rasteri/dISAppointment/README.md

# dISAppointment
Adding ISA slots to modern motherboards
