rasteri/dISAppointment/hardware/disappointment v1.stl

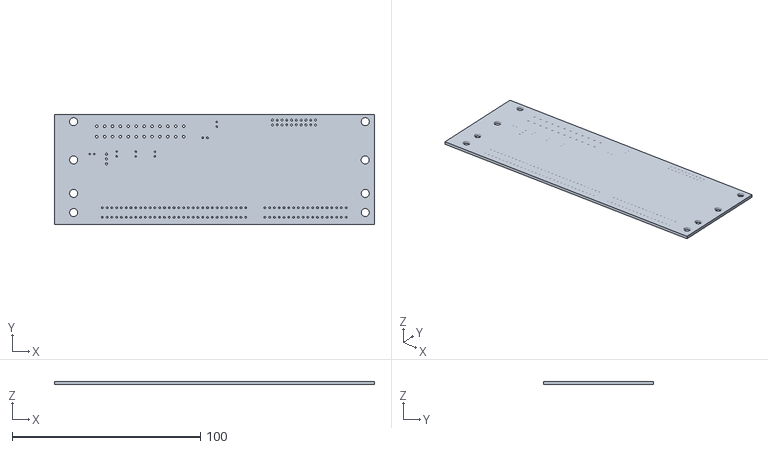
[picture p1: CAD file, 2023-08-16]
hardware/disappointment v1.stl
170.0 x 58.4 x 1.58
