rasteri/dISAppointment/hardware/NEW.pdf

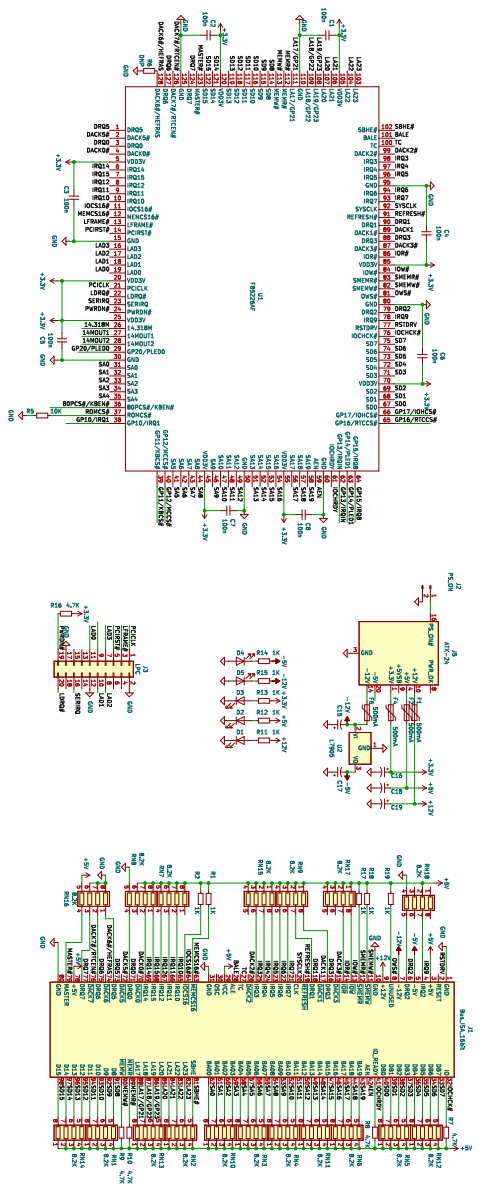
[picture p2: page 1]
