rasteri/dISAppointment/hardware/disappointment.kicad_pcb

## KiCad design hardware/disappointment.kicad_pcb (2025-01-30)

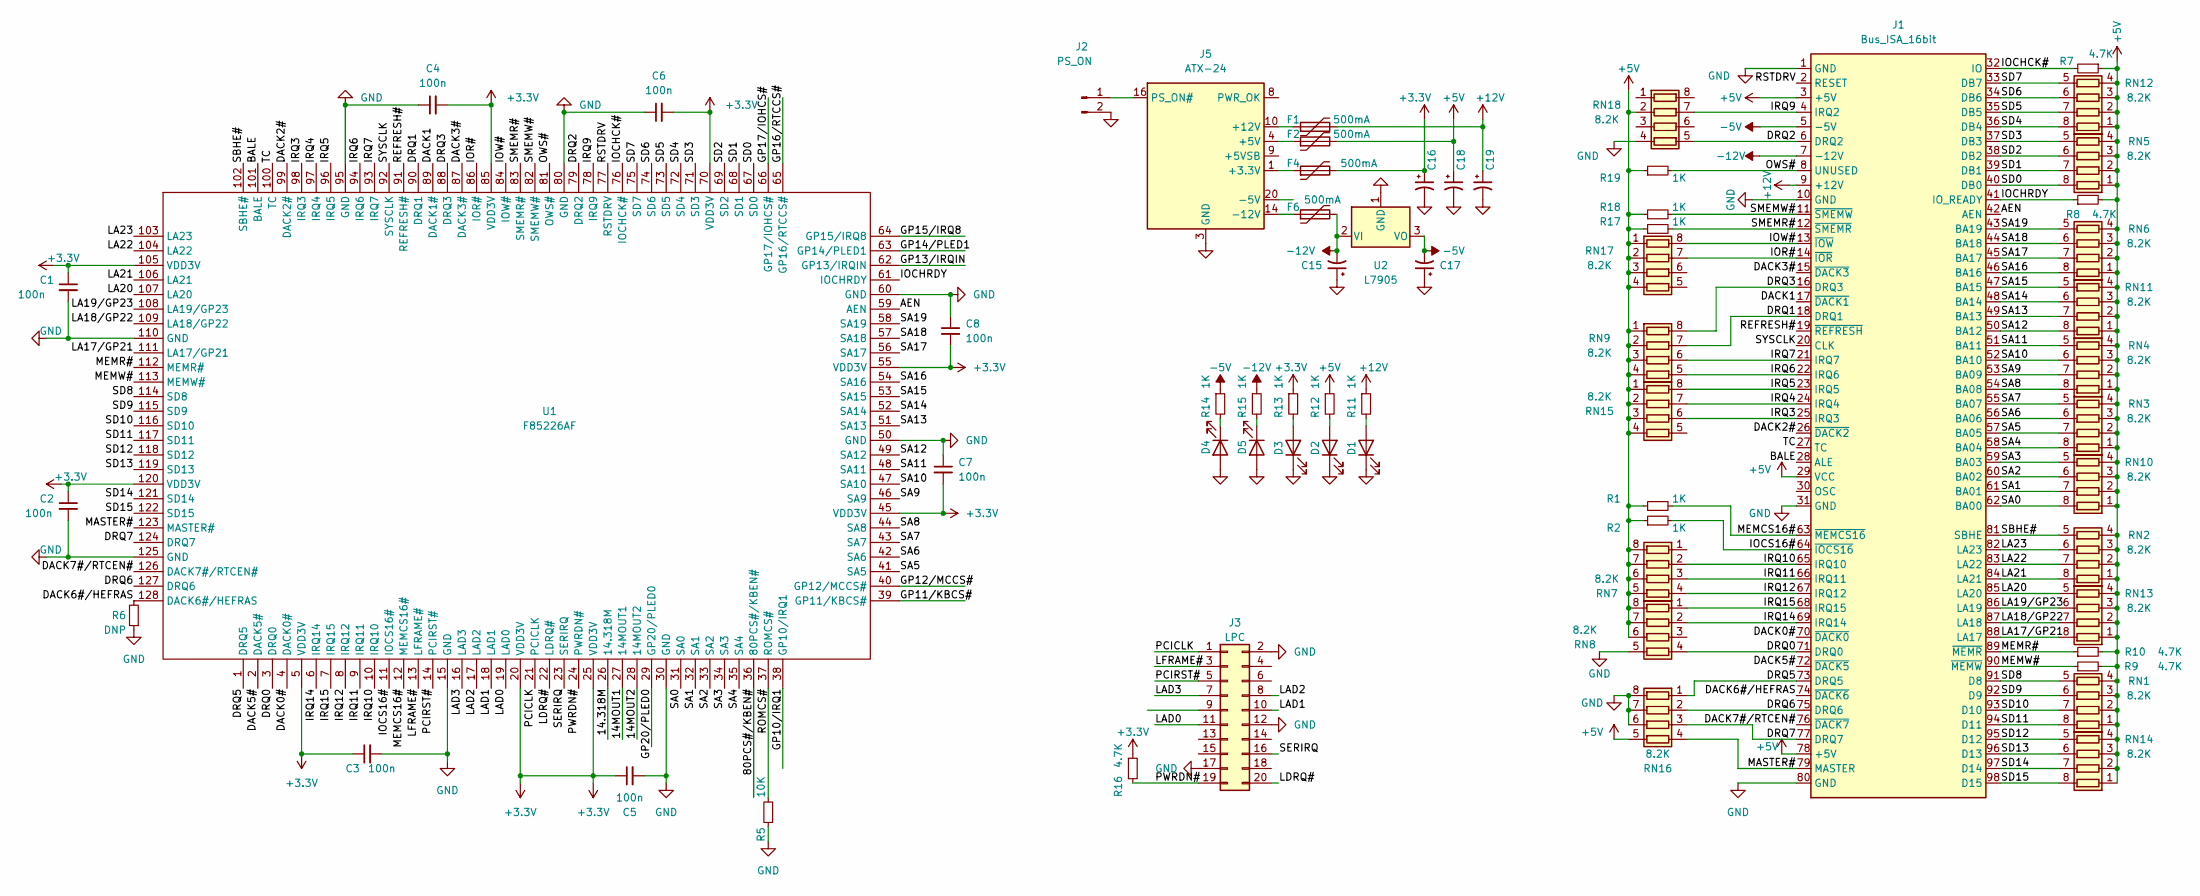
[picture p3: schematic disappointment.kicad_sch]

Parts:
C1, C2, C3, C4, C5, C6, C7, C8: 100n; C_1206_3216Metric
C15, C16, C17, C18, C19: 10uF; CP_Radial_D5.0mm_P2.50mm
D1, D2, D3, D4, D5: LED; LED_1206_3216Metric
F1, F2, F4, F6: 500mA; Fuse_1206_3216Metric
J1: Bus_ISA_16bit; ISA
J2: PS_ON; PinHeader_1x02_P2.54mm_Vertical
J3: LPC; PinHeader_2x10_P2.54mm_Vertical
J5: ATX-24; Molex_Mini-Fit_Jr_5566-24A_2x12_P4.20mm_Vertical
R1, R2, R11, R12, R13, R14, R15, R17, R18, R19: 1K; R_1206_3216Metric_Pad1.30x1.75mm_HandSolder
R5: 10K; R_1206_3216Metric_Pad1.30x1.75mm_HandSolder
R6: DNP; R_1206_3216Metric_Pad1.30x1.75mm_HandSolder
R7, R8, R9, R10, R16: 4.7K; R_1206_3216Metric_Pad1.30x1.75mm_HandSolder
RN1, RN2, RN3, RN4, RN5, RN6, RN7, RN8, RN9, RN10, RN11, RN12, RN13, RN14, RN15, RN16, RN17, RN18: 8.2K; R_Array_Concave_4x0603
U1: F85226AF; QFP-26x38_14x20_Pitch0.5mm
U2: L7905; TO-220-3_Vertical

Connections:
+3.3V: C1.1, C2.1, C3.1, C4.2, C5.1, C6.2, C7.2, C8.2, C16.1, F4.2, R13.1, R16.1, U1.5 (VDD3V), U1.20 (VDD3V), U1.25 (VDD3V), U1.45 (VDD3V), U1.55 (VDD3V), U1.70 (VDD3V), U1.85 (VDD3V), U1.105 (VDD3V), U1.120 (VDD3V)
+5V: C18.1, F2.2, J1.3 (+5V), J1.29 (VCC), J1.78 (+5V), R1.1, R2.1, R7.1, R8.2, R9.2, R10.2, R12.1, R17.1, R18.1, R19.1, RN1.1 (R1.1), RN1.2 (R2.1), RN1.3 (R3.1), RN1.4 (R4.1), RN2.1 (R1.1), RN2.2 (R2.1), RN2.3 (R3.1), RN2.4 (R4.1), RN3.1 (R1.1), RN3.2 (R2.1), RN3.3 (R3.1), RN3.4 (R4.1), RN4.1 (R1.1), RN4.2 (R2.1), RN4.3 (R3.1), RN4.4 (R4.1), RN5.1 (R1.1), RN5.2 (R2.1), RN5.3 (R3.1), RN5.4 (R4.1), RN6.1 (R1.1), RN6.2 (R2.1), RN6.3 (R3.1), RN6.4 (R4.1), RN7.5 (R4.2), RN7.6 (R3.2), RN7.7 (R2.2), RN7.8 (R1.2), RN8.6 (R3.2), RN8.7 (R2.2), RN8.8 (R1.2), RN9.1 (R1.1), RN9.2 (R2.1), RN9.3 (R3.1), RN9.4 (R4.1), RN10.1 (R1.1), RN10.2 (R2.1), RN10.3 (R3.1), RN10.4 (R4.1), RN11.1 (R1.1), RN11.2 (R2.1), RN11.3 (R3.1), RN11.4 (R4.1), RN12.1 (R1.1), RN12.2 (R2.1), RN12.3 (R3.1), RN12.4 (R4.1), RN13.1 (R1.1), RN13.2 (R2.1), RN13.3 (R3.1), RN13.4 (R4.1), RN14.1 (R1.1), RN14.2 (R2.1), RN14.3 (R3.1), RN14.4 (R4.1), RN15.1 (R1.1), RN15.2 (R2.1), RN15.3 (R3.1), RN15.4 (R4.1), RN16.5 (R4.2), RN17.1 (R1.1), RN17.2 (R2.1), RN17.3 (R3.1), RN17.4 (R4.1), RN18.2 (R2.1)
+12V: C19.1, F1.2, J1.9 (+12V), R11.1
-5V: C17.2, J1.5 (-5V), R14.1, U2.3 (VO)
-12V: C15.2, F6.2, J1.7 (-12V), R15.1, U2.2 (VI)
/14.318M: U1.26 (14.318M)
/14MOUT1: U1.27 (14MOUT1)
/14MOUT2: U1.28 (14MOUT2)
/80PCS#/KBEN#: U1.36 (80PCS#/KBEN#)
/AEN: J1.42 (AEN), U1.59 (AEN)
/BALE: J1.28 (ALE), U1.101 (BALE)
/DACK0#: J1.70 (~DACK0), U1.4 (DACK0#)
/DACK1: J1.17 (~DACK1), U1.89 (DACK1#)
/DACK2#: J1.26 (~DACK2), U1.99 (DACK2#)
/DACK3#: J1.15 (~DACK3), U1.87 (DACK3#)
/DACK5#: J1.72 (~DACK5), U1.2 (DACK5#)
/DACK6#/HEFRAS: J1.74 (~DACK6), R6.2, U1.128 (DACK6#/HEFRAS)
/DACK7#/RTCEN#: J1.76 (~DACK7), U1.126 (DACK7#/RTCEN#)
/DRQ0: J1.71 (DRQ0), RN8.4 (R4.1), U1.3 (DRQ0)
/DRQ1: J1.18 (DRQ1), RN9.7 (R2.2), U1.90 (DRQ1)
/DRQ2: J1.6 (DRQ2), RN18.5 (R4.2), U1.79 (DRQ2)
/DRQ3: J1.16 (DRQ3), RN9.8 (R1.2), U1.88 (DRQ3)
/DRQ5: J1.73 (DRQ5), RN16.1 (R1.1), U1.1 (DRQ5)
/DRQ6: J1.75 (DRQ6), RN16.2 (R2.1), U1.127 (DRQ6)
/DRQ7: J1.77 (DRQ7), RN16.3 (R3.1), U1.124 (DRQ7)
/GP10/IRQ1: U1.38 (GP10/IRQ1)
/GP11/KBCS#: U1.39 (GP11/KBCS#)
/GP12/MCCS#: U1.40 (GP12/MCCS#)
/GP13/IRQIN: U1.62 (GP13/IRQIN)
/GP14/PLED1: U1.63 (GP14/PLED1)
/GP15/IRQ8: U1.64 (GP15/IRQ8)
/GP16/RTCCS#: U1.65 (GP16/RTCCS#)
/GP17/IOHCS#: U1.66 (GP17/IOHCS#)
/GP20/PLED0: U1.29 (GP20/PLED0)
/IOCHCK#: J1.32 (IO), R7.2, U1.76 (IOCHCK#)
/IOCHRDY: J1.41 (IO_READY), R8.1, U1.61 (IOCHRDY)
/IOCS16#: J1.64 (~IOCS16), R2.2, U1.11 (IOCS16#)
/IOR#: J1.14 (~IOR), RN17.7 (R2.2), U1.86 (IOR#)
/IOW#: J1.13 (~IOW), RN17.8 (R1.2), U1.84 (IOW#)
/IRQ3: J1.25 (IRQ3), RN15.6 (R3.2), U1.98 (IRQ3)
/IRQ4: J1.24 (IRQ4), RN15.7 (R2.2), U1.97 (IRQ4)
/IRQ5: J1.23 (IRQ5), RN15.8 (R1.2), U1.96 (IRQ5)
/IRQ6: J1.22 (IRQ6), RN9.5 (R4.2), U1.94 (IRQ6)
/IRQ7: J1.21 (IRQ7), RN9.6 (R3.2), U1.93 (IRQ7)
/IRQ9: J1.4 (IRQ2), RN18.7 (R2.2), U1.78 (IRQ9)
/IRQ10: J1.65 (IRQ10), RN7.2 (R2.1), U1.10 (IRQ10)
/IRQ11: J1.66 (IRQ11), RN7.3 (R3.1), U1.9 (IRQ11)
/IRQ12: J1.67 (IRQ12), RN7.4 (R4.1), U1.8 (IRQ12)
/IRQ14: J1.69 (IRQ14), RN8.2 (R2.1), U1.6 (IRQ14)
/IRQ15: J1.68 (IRQ15), RN8.1 (R1.1), U1.7 (IRQ15)
/LA17/GP21: J1.88 (LA17), RN13.8 (R1.2), U1.111 (LA17/GP21)
/LA18/GP22: J1.87 (LA18), RN13.7 (R2.2), U1.109 (LA18/GP22)
/LA19/GP23: J1.86 (LA19), RN13.6 (R3.2), U1.108 (LA19/GP23)
/LA20: J1.85 (LA20), RN13.5 (R4.2), U1.107 (LA20)
/LA21: J1.84 (LA21), RN2.8 (R1.2), U1.106 (LA21)
/LA22: J1.83 (LA22), RN2.7 (R2.2), U1.104 (LA22)
/LA23: J1.82 (LA23), RN2.6 (R3.2), U1.103 (LA23)
/LAD0: J3.11, U1.19 (LAD0)
/LAD1: J3.10, U1.18 (LAD1)
/LAD2: J3.8, U1.17 (LAD2)
/LAD3: J3.7, U1.16 (LAD3)
/LDRQ#: J3.20, U1.22 (LDRQ#)
/LFRAME#: J3.3, U1.13 (LFRAME#)
/MASTER#: J1.79 (MASTER), RN16.4 (R4.1), U1.123 (MASTER#)
/MEMCS16#: J1.63 (~MEMCS16), R1.2, U1.12 (MEMCS16#)
/MEMR#: J1.89 (~MEMR), R10.1, U1.112 (MEMR#)
/MEMW#: J1.90 (~MEMW), R9.1, U1.113 (MEMW#)
/OWS#: J1.8 (UNUSED), R19.2, U1.81 (OWS#)
/PCICLK: J3.1, U1.21 (PCICLK)
/PCIRST#: J3.5, U1.14 (PCIRST#)
/PWRDN#: J3.19, R16.2, U1.24 (PWRDN#)
/REFRESH#: J1.19 (~REFRESH), U1.91 (REFRESH#)
/ROMCS#: R5.2, U1.37 (ROMCS#)
/RSTDRV: J1.2 (RESET), U1.77 (RSTDRV)
/SA0: J1.62 (BA00), RN10.8 (R1.2), U1.31 (SA0)
/SA1: J1.61 (BA01), RN10.7 (R2.2), U1.32 (SA1)
/SA2: J1.60 (BA02), RN10.6 (R3.2), U1.33 (SA2)
/SA3: J1.59 (BA03), RN10.5 (R4.2), U1.34 (SA3)
/SA4: J1.58 (BA04), RN3.8 (R1.2), U1.35 (SA4)
/SA5: J1.57 (BA05), RN3.7 (R2.2), U1.41 (SA5)
/SA6: J1.56 (BA06), RN3.6 (R3.2), U1.42 (SA6)
/SA7: J1.55 (BA07), RN3.5 (R4.2), U1.43 (SA7)
/SA8: J1.54 (BA08), RN4.8 (R1.2), U1.44 (SA8)
/SA9: J1.53 (BA09), RN4.7 (R2.2), U1.46 (SA9)
/SA10: J1.52 (BA10), RN4.6 (R3.2), U1.47 (SA10)
/SA11: J1.51 (BA11), RN4.5 (R4.2), U1.48 (SA11)
/SA12: J1.50 (BA12), RN11.8 (R1.2), U1.49 (SA12)
/SA13: J1.49 (BA13), RN11.7 (R2.2), U1.51 (SA13)
/SA14: J1.48 (BA14), RN11.6 (R3.2), U1.52 (SA14)
/SA15: J1.47 (BA15), RN11.5 (R4.2), U1.53 (SA15)
/SA16: J1.46 (BA16), RN6.8 (R1.2), U1.54 (SA16)
/SA17: J1.45 (BA17), RN6.7 (R2.2), U1.56 (SA17)
/SA18: J1.44 (BA18), RN6.6 (R3.2), U1.57 (SA18)
/SA19: J1.43 (BA19), RN6.5 (R4.2), U1.58 (SA19)
/SBHE#: J1.81 (SBHE), RN2.5 (R4.2), U1.102 (SBHE#)
/SD0: J1.40 (DB0), RN5.8 (R1.2), U1.67 (SD0)
/SD1: J1.39 (DB1), RN5.7 (R2.2), U1.68 (SD1)
/SD2: J1.38 (DB2), RN5.6 (R3.2), U1.69 (SD2)
/SD3: J1.37 (DB3), RN5.5 (R4.2), U1.71 (SD3)
/SD4: J1.36 (DB4), RN12.8 (R1.2), U1.72 (SD4)
/SD5: J1.35 (DB5), RN12.7 (R2.2), U1.73 (SD5)
/SD6: J1.34 (DB6), RN12.6 (R3.2), U1.74 (SD6)
/SD7: J1.33 (DB7), RN12.5 (R4.2), U1.75 (SD7)
/SD8: J1.91 (D8), RN1.5 (R4.2), U1.114 (SD8)
/SD9: J1.92 (D9), RN1.6 (R3.2), U1.115 (SD9)
/SD10: J1.93 (D10), RN1.7 (R2.2), U1.116 (SD10)
/SD11: J1.94 (D11), RN1.8 (R1.2), U1.117 (SD11)
/SD12: J1.95 (D12), RN14.5 (R4.2), U1.118 (SD12)
/SD13: J1.96 (D13), RN14.6 (R3.2), U1.119 (SD13)
/SD14: J1.97 (D14), RN14.7 (R2.2), U1.121 (SD14)
/SD15: J1.98 (D15), RN14.8 (R1.2), U1.122 (SD15)
/SERIRQ: J3.16, U1.23 (SERIRQ)
/SMEMR#: J1.12 (~SMEMR), R17.2, U1.83 (SMEMR#)
/SMEMW#: J1.11 (~SMEMW), R18.2, U1.82 (SMEMW#)
/SYSCLK: J1.20 (CLK), U1.92 (SYSCLK)
/TC: J1.27 (TC), U1.100 (TC)
GND: C1.2, C2.2, C3.2, C4.1, C5.2, C6.1, C7.1, C8.1, C15.1, C16.2, C17.1, C18.2, C19.2, D1.1 (K), D2.1 (K), D3.1 (K), D4.2 (A), D5.2 (A), J1.1 (GND), J1.10 (GND), J1.31 (GND), J1.80 (GND), J2.2, J3.2, J3.12, J3.17, J5.3 (GND), J5.5 (GND), J5.7 (GND), J5.15 (GND), J5.17 (GND), J5.18 (GND), J5.19 (GND), J5.24 (GND), R5.1, R6.1, RN8.5 (R4.2), RN16.6 (R3.2), RN16.7 (R2.2), RN16.8 (R1.2), RN18.4 (R4.1), U1.15 (GND), U1.30 (GND), U1.50 (GND), U1.60 (GND), U1.80 (GND), U1.95 (GND), U1.110 (GND), U1.125 (GND), U2.1 (GND)
unnamed: D1.2 (A), R11.2
unnamed: D2.2 (A), R12.2
unnamed: D3.2 (A), R13.2
unnamed: D4.1 (K), R14.2
unnamed: D5.1 (K), R15.2
unnamed: F1.1, J5.10 (+12V), J5.11 (+12V)
unnamed: F2.1, J5.4 (+5V), J5.6 (+5V), J5.21 (+5V), J5.22 (+5V), J5.23 (+5V)
unnamed: F4.1, J5.1 (+3.3V), J5.2 (+3.3V), J5.12 (+3.3V), J5.13 (+3.3V)
unnamed: J2.1, J5.16 (PS_ON#)
unnamed: F6.1, J5.14 (-12V)

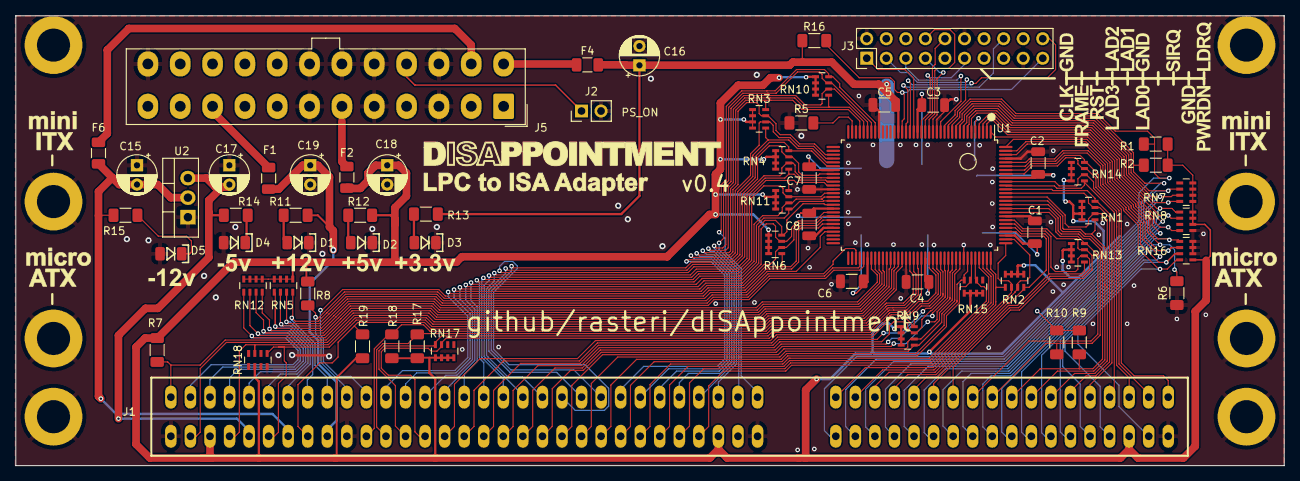
[picture p4: board disappointment.kicad_pcb from above]

Board: 2 copper layers, 164.7 x 58.4 mm, 63 parts (0 on the bottom side), 114 nets.
