rasteri/dISAppointment/(threads)

Thread 1 (2023-04-13):

Small bug in sapphisa.c

i440bx, 2023-04-13:
Hi,

in line 213 - 217 you disable the power management of the chip. But you send two times the same flags.
https://github.com/rasteri/dISAppointment/blob/5d25a476c166709765c10503f642b00895f9b2d3/software/sapphisa.c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

I think in 216 you want to send 0x52 ?

Thanks,
Robert

Thread 2 (2023-04-16):

Value of the resistor networks?

sycophantic, 2023-04-16:
The schematic shows the value of the resistor networks as "R_Network08", what is the actual value?

lss4, 2023-06-12:
Per [this post](https://www.vogons.org/viewtopic.php?p=1157095#p1157095) in VOGONS, 4K7 resistors were used, though it can be any reasonable value up to 10K. I'm using 4K7 as suggested in my build.

I couldn't find the original 745C101, but any 1206x5 bussed resistor array of matching pinout and appropriate value should do.

Thread 4 (2025-03-09):

Modernize, plus Floppy Controller Support

CDRXavier, 2025-03-09:
Hi, been looking for something like this for years.
Technically, the LPC bus is broken out onto the TPM header. However, I don't think most BIOSes have the code for detecting a floppy controller. Alas.

The LPC bus don't have PCI signal breakouts, so I imagine I will have to "inject" a PCI slot somehow. a PCIe to PCI bridge chip doesn't sound like the worst idea.

In addition, the [w83626](https://media.digikey.com/pdf/data%20sheets/nuvoton%20pdfs/w83626f,d,g.pdf) seems to have similar features, but are slightly more easier to obtain.

I see the difficulty is in acquiring IRQ signals. The modern platforms' more limited IRQ amount also does not help.

But PCIe have IRQ? and can map?
Though at this point straight-up FPGA-ing a PCIe floppy controller is likely more manageable.

CDRXavier, 2025-03-09:
In addition, I believe there were products called "PCI to ISA adapter", and I want to say I have seen some (but definitely not in person).
And I certainly know of PCIe to PCI adapter/bridge chips.

CDRXavier, 2025-03-30:
It also occured to me that my X11SSM board have a full LPC header, complete with the interrupt pin. Does the C236 chipset have the disabled DMA?

rasteri, 2025-03-31:
Yeah you ain't getting a C236 to work with DMA.

PCI to ISA adapters stopped working with DMA after ICH5 chipsets (I've been doing some research on them)

And pcie has never worked for DMA/IRQ, unfortunately.
