rasteri/dISAppointment/(commit log)

2023-05-14 started rerouting PCB
    [disappointment.kicad_pcb, disappointment.kicad_sch]
2023-05-20 getting there
    [disappointment.kicad_pcb, disappointment.kicad_sch]
2023-05-24 getting there more
    [disappointment.kicad_pcb, disappointment.kicad_sch]
2023-06-15 about done
    [disappointment.kicad_pcb, disappointment.kicad_sch]
2023-06-17 LEDs, -5v regulator
    [disappointment.kicad_pcb, disappointment.kicad_sch]
2023-08-16 what a... letdown?
    [disappointment v1.stl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]
2023-11-12 added the correct resistors
    [disappointment.kicad_pcb, disappointment.kicad_sch]
2025-01-30 silkscreen cleanup
    [disappointment-B_Cu.gbr, disappointment-B_Mask.gbr, disappointment-B_Silkscreen.gbr, disappointment-Edge_Cuts.gbr, disappointment-F_Cu.gbr, disappointment-F_Mask.gbr, disappointment-F_Silkscreen.gbr, disappointment-NPTH.drl]
